bin316/beidou_4g/Docs/ChangeLogs/2026-09-20.md

# 2026-09-20

- 功能码 0 恢复 `geo_source` 字节；数据域固定为 26 字节，整帧固定为 37 字节。
- GNSS NVM 记录新增格式魔数与定位来源，旧格式启动时清空坐标并写入新记录。
- GNSS、LBS 和功能码 19 坐标写入分别持久化来源值 1、2、3；上报从同一 GNSS 快照读取坐标与来源。
- 验证：ARM GCC 已完成相关源文件语法检查；尚未进行实机重启、Flash 同步失败注入和服务端联调。
