bin316/beidou_4g/Docs/ChangeLogs/2026-09-22.md

# 2026-09-22

- 功能码 13 改为验证主备 TCP 连接后再提交系统参数；失败时恢复旧系统、传感器和 LTE 配置，并尝试重连原活动端点。
- AIR780 TCP 连接支持按调用方指定每次超时、尝试次数和退避间隔；失败尝试会清理链路状态并喂狗。
- Flash 同步返回擦除、编程与读回校验结果，功能码 13 可在提交失败时回退。
- 兼容 v2.2 功能码 26–33：雨量功能未编译时，回复对应的“功能不可用”结果码；功能码 0 上报结构未改动。
- 验证：ARM GCC 已完成 NVM、AIR780EP、Solution 语法检查；尚未进行 Air780E、服务端与 Flash 故障注入实测。
