bin316/beidou_4g/Docs/ChangeLogs/2026-09-23.md

# 2026-09-23

- 功能码 0 上报的倾角字段改为 `uint8_t`（0～180°），数据域调整为 25 字节，整帧调整为 36 字节。
- 验证：已通过协议结构体静态断言与源码检索；尚未进行服务端联调或硬件实测。
- 功能码 17 固件版本查询仅接受零长度数据域；合法请求回复功能码 16 的年、月、修订号及活动槽位。
- 单槽固件默认上报活动槽位 A（`active_slot=0`），并补充版本回复帧与运行日志说明。
- 验证：已完成协议字段检索与 `git diff --check`；当前环境无 ARM 交叉编译器，未进行编译、服务端联调或硬件实测。
