bin316/beidou_4g/Docs/IssueLogs/2026-09-23.md

# 2026-09-23

## [待验证] 倾角上报仅出现 0～90°

- 现象：上报倾角观测值仅在 0～90° 范围内，需确认是否应覆盖倒置姿态。
- 证据：`util_calculate_angle_relative_to_z()` 使用 `acosf(z / |a|)` 计算重力向量与 +Z 轴的夹角，理论结果为 0～180°；上报端仅将该值转换为 `uint8_t`，未作 90° 限幅。
- 判断：若持续小于等于 90°，测量时的 Z 轴加速度未为负。可能是设备只在正 Z 半球倾斜，或传感器安装方向/轴符号与预期不一致；尚无原始三轴实测值，不能确认具体原因。
- 方案：待实施。分别在正放、侧放、倒置静止时记录上报的 X/Y/Z 与倾角；倒置时 Z 应为负且倾角应接近 180°。若业务需要“相对初始姿态的双向倾角”，需另行定义参考面与符号编码。
- 验证：已完成源码链路检查；未进行硬件姿态测试。
