bin316/beidou_4g/solution/Solution.h

/*
 * Solution.h
 *
 *  Created on: Jan 22, 2025
 *      Author: IRIS
 */

#ifndef SOLUTION_H_
#define SOLUTION_H_

#include "Protocol.h"
#include "utilties.h"

//******FreeRTOS Family Bucket******//
#include "FreeRTOS.h"
#include "cmsis_os2.h"
#include "timers.h"
#include "queue.h"
#include "task.h"
#include "message_buffer.h"
#include "stream_buffer.h"
#include "semphr.h"

#include "os_Allocator.hpp"
#include "NVM.h"

#include "AIR780EP.h"

typedef enum : uint8_t
    {
    wm_idle,
    wm_work,
    wm_factory = 0xFF
    } solution_mode_e;

typedef struct
    {
    pb_runningConfig runningConfig;
    pb_systemConfig systemConfig;
    password pwd;
    solution_mode_e mode;
    uint8_t configEditting = 0;
    uint8_t passwordConfirm = 0;
    password newPassword =
	{
	0
	};
    util_lowpower_wake_source_e wakeSource =
	    util_lowpower_wake_source_e::regular;
    bool connect_to_main_server = false;
    bool updatePositionOnStart = false;
    /** 定位开关 bit0 GNSS / bit1 AGNSS / bit2 LBS，随 solution NVM 持久化 */
    uint8_t locate_switch = 0;

    void clear_work(void)
	{
	pwd =
	    {
	    0
	    };
	mode = solution_mode_e::wm_factory;
	configEditting = 0;
	passwordConfirm = 0;
	newPassword =
	    {
	    0
	    };
	wakeSource = util_lowpower_wake_source_e::regular;
	}
    } solution_handle;

class Solution: public osAllocator<Solution>
    {
public:
    Solution(void);

private:

    solution_handle rt_solution;

    NVM *nvm;

    AIR780EP *air;

    bool solution_boot_fine = false;

    uint32_t parse_unix_time(void);
    void unique_identifier_generate(void);

    void report(void);
    void restart(void);
    void timers_create(void);
    void refresh_server(void);
    /** 重置设备休眠倒计时；硬计时策略下收包路径不再调用 */
    void refresh_device(void);

    int send_message(void *msg, uint16_t len);
    int read_message(void *dest, uint16_t len);

    void event_process(void);
    void setup_network(void);

    void event_action_vibration(void);
    void event_action_message(void);
    /** 从业务 TCP 字节流持续提取完整协议帧，兼容黏包和拆包。 */
    void process_downlink_frame(uint8_t *message, size_t received_size);
    /** Timer 投递的服务器超时上报（工作线程执行） */
    void event_action_server_report(void);
    /** Timer 投递的在线超时休眠（工作线程执行） */
    void event_action_device_sleep(void);
    /** 按 locate_switch 启 GNSS/AGNSS（不含 LBS） */
    void start_locate(void);
    /** 震动唤醒路径调用：locateSwitch.LBS 开且北斗未定住时启 LBS 会话 */
    void start_lbs_if_needed(void);
    /** 对齐 Slope：启 LBS 会话（满 4h 后本唤醒最多 N 次，事件循环执行） */
    void lbs_session_start(void);
    /** 对齐 Slope：处理到期的 LBS 查询/重试 */
    void lbs_process_due(void);
    /** LBS 失败/暂不可用时改期重试 */
    void lbs_schedule_retry(void);

    void message_report(void);
    void message_upload_run_parameters(void);
    void message_change_run_parameters(pb_runningConfig *params);
    void message_sleep(void);
    /** 功能码 9：进/退配置模式、改密；req 为 null 或 dataLen 非法时回失败 */
    void message_enter_config_mode(pb_configModeReq *req);
    void message_upload_sys_parameters(void);
    void message_change_sys_parameters(pb_systemConfig *params);
    void message_change_execute_mode(solution_mode_e *mode);
    /** 下行 17 的零长度查询：上行 16 回 year/month/revision/active_slot。 */
    void message_upload_firmware_version(void);
    /** 下行19：写经纬度到 GNSS 缓存并落 NVM */
    void message_config_locate_geo(pb_locateGeo *geo);
    /** 下行21：改 locateSwitch；应答20：1成功/0一般失败/2非法AGNSS */
    void message_config_locate_switch(uint8_t *value);
    /** 下行23：查询 locateSwitch */
    void message_upload_locate_switch(void);
    /**
     * 下行25：OTA 请求；本机无升级能力时桩应答上行24
     * dataLen 非法→result=5；否则→result=0（拒绝）
     */
    void message_ota_request(const pb_otaRequest *req);
    /** 雨量功能未编译时，用 v2.2 对应结果码明确返回“不支持”。 */
    void message_rain_feature_unsupported(e_pb_func response_func,
	uint8_t unavailable_result);
    /** 功能码 35：仅当前唤醒抑制自动休眠；0/1 成功回显，非法值以功能码 34 回 0xFF。 */
    void message_keep_online_this_wake(uint8_t value);
    /** 服务器 OK：仅 awaiting_report_ok_ 时可能休眠（对齐 Inclination） */
    void message_heartbeat(void);
    void mark_report_pending_ack(void);
    void clear_report_pending_ack(void);

    /** true=最近一次成功发出 up_report，下一条 OK 视为上报确认 */
    bool awaiting_report_ok_ = false;
    /** 仅 RAM 有效；本次唤醒期间拦截 OK/超时触发的自动休眠。 */
    bool keep_online_this_wake_ = false;

    /** Timer 回调只置位；工作线程轮询并执行可能阻塞的上报/休眠。 */
    volatile bool server_report_due_ = false;
    volatile bool device_sleep_due_ = false;

    static constexpr size_t kDownlinkFrameCapacity = 320u;
    uint8_t downlink_frame_[kDownlinkFrameCapacity] = {};
    size_t downlink_frame_len_ = 0u;

    /** 当前配置会话意图（RAM）；进 Standby/退出时清零，不落 NVM */
    uint8_t config_intent_ = 0;
    /** 是否允许执行指定写功能码（配置态且 intent 匹配） */
    bool config_write_allowed(uint8_t write_func) const;
    /** 进 Standby 前清除配置会话，避免跨睡残留 editing 而无 intent */
    void clear_config_session_for_standby(void);

    /** 功能码 13 验证新端点期间阻止定时器投递 report/休眠事件。 */
    bool endpoint_switch_in_progress_ = false;
    bool endpoint_switch_endpoint_valid(const uint8_t ip[4],
	uint16_t port) const;
    bool endpoint_switch_connect(AIR780EP::air780_server_t server,
	uint8_t attempts);
    void endpoint_switch_pause_timers(bool *server_was_active,
	bool *device_was_active);
    void endpoint_switch_resume_timers(bool server_was_active,
	bool device_was_active);

//	服务器响应超时定时器相关变量
    TimerHandle_t server_timeout_timer;
    const char *server_timeout_timer_name = "server_timeout_timer";
    static void server_timeout_timer_callback(TimerHandle_t xTimer);
//	设备超时休眠定时器相关变量
    TimerHandle_t device_timeout_timer;
    const char *device_timeout_timer_name = "device_timeout_timer";
    static void device_timeout_timer_callback(TimerHandle_t xTimer);
    /** LBS 失败/暂不可用时的改期定时器（对齐 Slope） */
    TimerHandle_t lbs_retry_timer = nullptr;
    static void lbs_retry_timer_callback(TimerHandle_t xTimer);

    TaskHandle_t solution_thread_handle = NULL;
    static void solution_work_routine_thread(void *argument);
    static void solution_idle_routine_thread(void *argument);
    static void solution_fact_routine_thread(void *argument);
    };

#endif /* SOLUTION_H_ */
