bin316/beidou_4g/bsp/util_low_power.cpp

/*
 * util_low_power.cpp
 *
 *  Created on: Oct 21, 2024
 *      Author: IRIS
 */

#include "PRODUCT_CONFIG.h"

#include "main.h"
#include "i2c.h"
#include "rtc.h"
#ifdef DEBUG
#include "usart.h"
#endif
#if PROD_CONFIG_FACTORY_ENABLE_IWDG
#include "iwdg.h"
#endif

#include "stdint-gcc.h"
#include "stdio.h"
#include "stdlib.h"
#include "string.h"
#include "typeinfo"
#include "time.h"

#include "FreeRTOS.h"
#include "task.h"
#include "queue.h"
#include "stream_buffer.h"
#include "message_buffer.h"
#include "semphr.h"
#include "timers.h"

#include "utilties.h"

#include "magic_enum.hpp"
using namespace magic_enum;

static util_lowpower_wake_source_e wake_source =
		util_lowpower_wake_source_e::pin;

static util_lowpower_config_s factory_lowpower_config = { .wake_pin_enable =
		false, .requested_wakeup_period = 0, .wakeup_remain = 0, };

static util_lowpower_config_s rt_lowpower_config;

#include "NVM.h"

NVM *nvm_lopwr = NULL;

#if PROD_CONFIG_FACTORY_ENABLE_IWDG
static TimerHandle_t iwdg_feed_timer = NULL;
#endif
//this delay must be greater than 0.1s
#define LOWPOWER_STANDBY_DELAY	250

#if PROD_CONFIG_FACTORY_ENABLE_IWDG
static void util_lowpower_iwdg_refresh_timer_callback(TimerHandle_t xtimer) {
	util_lowpower_iwdg_feed();
	HAL_GPIO_TogglePin(LED_BOOT_GPIO_Port, LED_BOOT_Pin);
}
#endif
/*
 * 低功耗初始化流程：
 *	1. 读取配置，检查是否需要休眠
 *		1)如果处在休眠状态（剩余时长不为0），根据剩余的休眠时长继续休眠
 *		2)如果剩余时长为0，退出休眠状态，初始化完成，系统继续运行
 * */
extern int INT1_PIN_STATE;
void __util_lowpower_init__(void) {
	// 检查是否是由RTC唤醒
	nvm_lopwr = new NVM(NVM::partition_lowpower, &rt_lowpower_config,
			&factory_lowpower_config, sizeof(rt_lowpower_config));
	configASSERT(nvm_lopwr != NULL);
	nvm_lopwr->load();
	if (nvm_lopwr->isFactoryDefault()) {
		nvm_lopwr->restoreDefault();
		nvm_lopwr->save();
		logInfo("NVM: 已恢复出厂默认");
	}

	/*timezone setup：POSIX 符号与日常相反，UTC-8 = 东八区北京时间（对齐 Inclination） */
	setenv("TZ", "UTC-8", 1);
	tzset();             // 更新时区设置

	/* 上电打印复位原因，便于区分 IWDG / SoftReset(HardFault后) / 引脚复位 */
	{
		const uint32_t csr = RCC->CSR;
		if (csr & RCC_CSR_IWDGRSTF) {
			logWarning("复位原因: 独立看门狗(IWDG)");
		}
		if (csr & RCC_CSR_SFTRSTF) {
			logWarning("复位原因: 软件复位(常见于HardFault闪灯后SystemReset)");
		}
		if (csr & RCC_CSR_PINRSTF) {
			logInfo("复位原因: NRST引脚(常与其它标志同时置位)");
		}
		if (csr & RCC_CSR_BORRSTF) {
			logWarning("复位原因: 欠压BOR");
		}
		__HAL_RCC_CLEAR_RESET_FLAGS();
	}

	/*
	 * 创建看门狗刷新定时器
	 * 创建后立即刷新一次看门狗，然后再启动定时器
	 * */
#if PROD_CONFIG_FACTORY_ENABLE_IWDG
	util_lowpower_iwdg_feed();
	iwdg_feed_timer = xTimerCreate("iwdg_refresh", pdMS_TO_TICKS(200), pdTRUE,
	NULL, util_lowpower_iwdg_refresh_timer_callback);
	configASSERT(iwdg_feed_timer!=NULL);
	xTimerStart(iwdg_feed_timer, portMAX_DELAY);
	logInfo("看门狗: 喂狗定时器已创建");
#endif
// 检查是否是由Wake Up引脚唤醒
	if (__HAL_PWR_GET_FLAG(PWR_FLAG_WU) || INT1_PIN_STATE
			|| __HAL_PWR_GET_FLAG(PWR_FLAG_WUF1)
			|| (HAL_GPIO_ReadPin(SENSOR_INT1_GPIO_Port, SENSOR_INT1_Pin)
					== GPIO_PIN_SET)) {
		// 清除Wake Up引脚唤醒标志
		wake_source = util_lowpower_wake_source_e::pin;
	} else if (__HAL_RTC_WAKEUPTIMER_GET_FLAG(&hrtc, RTC_FLAG_WUTF)) {
		// 清除RTC唤醒标志
		__HAL_RTC_WAKEUPTIMER_CLEAR_FLAG(&hrtc, RTC_FLAG_WUTF);
		wake_source = util_lowpower_wake_source_e::rtc;
	} else {
		wake_source = util_lowpower_wake_source_e::regular;
	}
	logInfo("唤醒源: %s", enum_name(wake_source).data());

	if (rt_lowpower_config.wakeup_remain == 0) {
		logInfo("低功耗: 休眠结束(剩余0)");
		return;
	}
	if (rt_lowpower_config.wake_pin_enable
			&& wake_source == util_lowpower_wake_source_e::pin) {
		rt_lowpower_config.wakeup_remain = 0;
		nvm_lopwr->save();
		logInfo("低功耗: 引脚打断休眠");
		return;
	}

	/*持续休眠流程*/
	uint32_t seconds = 0;
	if (rt_lowpower_config.wakeup_remain > 64800) {
		/*如果剩余休眠时间大于18h...*/
		seconds = 64800;
		rt_lowpower_config.wakeup_remain -= 64800;
	} else {
		/*如果剩余休眠时间小于18h...*/            
		seconds = rt_lowpower_config.wakeup_remain;
		rt_lowpower_config.wakeup_remain = 0;
	}

	logInfo("低功耗: 继续休眠, 剩余%d秒",
			rt_lowpower_config.wakeup_remain);

	nvm_lopwr->save();
	/*$notice 继续休眠时，写入一次flash*/
	__flash_sync();
	// 设置RTC唤醒定时器
	HAL_RTCEx_SetWakeUpTimer_IT(&hrtc,
			(seconds > 2) ? (seconds - 1) : (seconds),
			RTC_WAKEUPCLOCK_CK_SPRE_16BITS);
	// 清除RTC和Wake Up标志
	__HAL_RTC_WAKEUPTIMER_CLEAR_FLAG(&hrtc, RTC_FLAG_WUTWF);
	__HAL_RTC_WAKEUPTIMER_CLEAR_FLAG(&hrtc, RTC_FLAG_WUTF);
	__HAL_PWR_CLEAR_FLAG(PWR_FLAG_WU);
	__HAL_PWR_CLEAR_FLAG(PWR_FLAG_WUF1);
	HAL_PWREx_EnableInternalWakeUpLine();

	// 进入待机模式
//	HAL_PWREx_EnterSHUTDOWNMode();
	HAL_PWREx_EnablePullUpPullDownConfig(); // 允许 Standby 模式下的上下拉配置
	HAL_PWREx_EnableGPIOPullDown(PWR_GPIO_A, PWR_GPIO_BIT_0);
	HAL_PWREx_EnableGPIOPullDown(PWR_GPIO_A, PWR_GPIO_BIT_1);
	HAL_PWR_EnterSTANDBYMode();
}

/*
 * 休眠流程：
 * 	1.读取（同步）低功耗配置
 * 	2.等待一段时间，确保所有设备完成操作
 * 	3.根据设定的总休眠时间计算本次休眠时间
 * 	4.根据唤醒源设置唤醒中断
 *
 * */
void util_lowpower_standby(void) {
	unsigned int seconds;
	bool wake_pin_enable = rt_lowpower_config.wake_pin_enable;
	logInfo("低功耗: 唤醒引脚%s", wake_pin_enable ? "开" : "关");
	/*
	 * 根据requested_wakeup_period开启一次新的休眠
	 * */
	if (rt_lowpower_config.requested_wakeup_period < 3) {
		rt_lowpower_config.wakeup_remain = 0;
		rt_lowpower_config.requested_wakeup_period = 0;
		/*最低休眠3s*/
		seconds = 3;
	}
	if (rt_lowpower_config.requested_wakeup_period > 64800) {
		seconds = 64800;
		rt_lowpower_config.wakeup_remain =
				rt_lowpower_config.requested_wakeup_period - 64800;
	} else {
		seconds = rt_lowpower_config.requested_wakeup_period;
		rt_lowpower_config.wakeup_remain = 0;
	}

	logInfo("低功耗: 请求休眠%d秒",
			rt_lowpower_config.requested_wakeup_period);
	logInfo("低功耗: 剩余分段%d秒", rt_lowpower_config.wakeup_remain);
	logInfo("低功耗: 本段休眠%d秒", seconds);

	nvm_lopwr->save();

	__flash_sync();
	//	等待其余设备执行完成

	/* 任何等待都必须在 critical 前完成，critical 内只保留待机寄存器配置。 */
	vTaskDelay(pdMS_TO_TICKS(LOWPOWER_STANDBY_DELAY));

	taskENTER_CRITICAL();
//	进入关键区后，所有依赖freertos的组件都将失效（包括调试串口）
// 使能唤醒中断
	if (wake_pin_enable) {
		HAL_PWR_EnableWakeUpPin(PWR_WAKEUP_PIN1);
	} else {
		HAL_PWR_DisableWakeUpPin(PWR_WAKEUP_PIN1);
	}

	// debug: 强制禁用唤醒引脚
	// HAL_PWR_DisableWakeUpPin(PWR_WAKEUP_PIN1);

// 设置RTC唤醒定时器
	HAL_RTCEx_SetWakeUpTimer_IT(&hrtc,
			(seconds > 2) ? (seconds - 1) : (seconds),
			RTC_WAKEUPCLOCK_CK_SPRE_16BITS);
	HAL_PWREx_EnableInternalWakeUpLine();
// 清除RTC和Wake Up标志

	/*$notice 请求休眠时，写入一次flash*/
// 进入待机模式
	__HAL_RTC_WAKEUPTIMER_CLEAR_FLAG(&hrtc, RTC_FLAG_WUTWF);
	__HAL_RTC_WAKEUPTIMER_CLEAR_FLAG(&hrtc, RTC_FLAG_WUTF);

	__HAL_PWR_CLEAR_FLAG(PWR_FLAG_WUF1);
	__HAL_PWR_CLEAR_FLAG(PWR_FLAG_WUF2);
	__HAL_PWR_CLEAR_FLAG(PWR_FLAG_WUF3);
	__HAL_PWR_CLEAR_FLAG(PWR_FLAG_WUF4);
	__HAL_PWR_CLEAR_FLAG(PWR_FLAG_WUF5);
	__HAL_PWR_CLEAR_FLAG(PWR_FLAG_WU);
	__HAL_PWR_CLEAR_FLAG(PWR_FLAG_SB);

#ifdef DEBUG
	// 串口日志已经失效，使用普通的串口打印输出
	uartPrintStr(&huart2, "\r\n进入休眠状态\r\n");
#endif

	HAL_PWREx_EnablePullUpPullDownConfig(); // 允许 Standby 模式下的上下拉配置
	HAL_PWREx_EnableGPIOPullDown(PWR_GPIO_A, PWR_GPIO_BIT_0);
	HAL_PWREx_EnableGPIOPullDown(PWR_GPIO_A, PWR_GPIO_BIT_1);
	HAL_PWR_EnterSTANDBYMode();

	/*should never reach here*/
	taskEXIT_CRITICAL();
}

util_lowpower_wake_source_e util_lowpower_get_wake_source(void) {
	return wake_source;
}

util_lowpower_config_s util_lowpower_get_config(void) {
	return rt_lowpower_config;
}
void util_lowpower_set_config(util_lowpower_config_s config) {
	rt_lowpower_config.requested_wakeup_period = config.requested_wakeup_period;
	rt_lowpower_config.wake_pin_enable = config.wake_pin_enable;
	rt_lowpower_config.wakeup_remain = config.wakeup_remain;
	nvm_lopwr->save();
}

void util_lowpower_iwdg_feed(void) {
#if PROD_CONFIG_FACTORY_ENABLE_IWDG
	HAL_IWDG_Refresh(&hiwdg);
#endif
}

/*
 * @brief 用 unix 时间写 RTC（按当前 TZ，工程为东八区）
 * @return 0 成功；-1 时间非法（不改 RTC）
 */
int util_lowpower_update_rtc(time_t time) {
	/* mktime 失败为 -1；拒绝写入以免 Year 下溢成 2226 等脏值 */
	if (time == (time_t) -1 || time < 0) {
		logWarning("RTC: 拒绝非法时间戳 %ld", (long) time);
		return -1;
	}

	struct tm *plocal = localtime(&time);
	if (plocal == nullptr) {
		logWarning("RTC: localtime 失败 时间戳 %ld", (long) time);
		return -1;
	}
	struct tm local = *plocal;

	/* STM32 RTC 年字段仅 0..99（2000..2099） */
	if (local.tm_year < 100 || local.tm_year > 199) {
		logWarning("RTC: 年份越界 tm_year=%d", local.tm_year);
		return -1;
	}

	RTC_TimeTypeDef sTime;
	RTC_DateTypeDef sDate;

	sTime.Hours = (uint8_t) local.tm_hour;
	sTime.Minutes = (uint8_t) local.tm_min;
	sTime.Seconds = (uint8_t) local.tm_sec;

	sDate.WeekDay = (uint8_t) local.tm_wday;
	sDate.Month = (uint8_t) (local.tm_mon + 1);
	sDate.Date = (uint8_t) local.tm_mday;
	sDate.Year = (uint8_t) (local.tm_year - 100);

	logInfo("RTC: 已设置 %02d:%02d:%02d %02d/%02d/%02d", sTime.Hours,
			sTime.Minutes, sTime.Seconds, sDate.Year + 2000, sDate.Month,
			sDate.Date);
	logInfo("RTC: 时间戳 %ld", (long) time);
	HAL_RTC_SetDate(&hrtc, &sDate, RTC_FORMAT_BIN);
	HAL_RTC_SetTime(&hrtc, &sTime, RTC_FORMAT_BIN);
	return 0;
}

time_t util_lowpower_get_rtc(void) {
	time_t time;
	struct tm local;

	RTC_TimeTypeDef sTime;
	RTC_DateTypeDef sDate;

	HAL_RTC_GetTime(&hrtc, &sTime, RTC_FORMAT_BIN);
	HAL_RTC_GetDate(&hrtc, &sDate, RTC_FORMAT_BIN);

	local.tm_hour = sTime.Hours;
	local.tm_min = sTime.Minutes;
	local.tm_sec = sTime.Seconds;
	local.tm_wday = sDate.WeekDay;
	local.tm_mon = sDate.Month - 1;
	local.tm_mday = sDate.Date;
	local.tm_year = sDate.Year + 100;

	time = mktime(&local);

	return time;
}
