bin316/beidou_4g/bsp/util_system_events.cpp

/*
 * events.cpp
 *
 *  Created on: Oct 21, 2024
 *      Author: IRIS
 */

#include <utilties.h>
#include "main.h"

#include "stdint-gcc.h"
#include "stdio.h"
#include "stdlib.h"
#include "string.h"

#include "FreeRTOS.h"
#include "task.h"
#include "queue.h"
#include "stream_buffer.h"
#include "message_buffer.h"
#include "semphr.h"
#include "event_groups.h"

#include "utilties.h"
#include "log.h"

static QueueHandle_t event_queue;

#define IDLE_EVENT_DELAY 100

void __util_events_init__(void) {
	event_queue = xQueueCreate(16, sizeof(util_event_code_t));
	configASSERT(event_queue);
	logInfo("事件队列: 已初始化");
}

void util_events_generate(util_event_code_t code) {
	if (xPortIsInsideInterrupt()) {
		xQueueSendFromISR(event_queue, &code, NULL);
	} else {
		xQueueSend(event_queue, &code, portMAX_DELAY);
	}
}

void util_events_generate_noblock(util_event_code_t code) {
	if (event_queue == NULL) {
		return;
	}
	if (xPortIsInsideInterrupt()) {
		BaseType_t hpw = pdFALSE;
		(void) xQueueSendFromISR(event_queue, &code, &hpw);
		portYIELD_FROM_ISR(hpw);
	} else {
		(void) xQueueSend(event_queue, &code, 0);
	}
}

bool util_events_poll(util_event_code_t *code, size_t timeout) {
	return xQueueReceive(event_queue, code, pdMS_TO_TICKS(timeout));
}

bool util_events_poll_nonblocked(util_event_code_t *code) {
	return xQueueReceive(event_queue, code, 0);
}

int util_events_flush(void) {
	int dropped = 0;
	util_event_code_t code;
	while (xQueueReceive(event_queue, &code, 0) == pdPASS) {
		dropped++;
	}
	if (dropped > 0) {
		logInfo("事件队列: 清空%d条", dropped);
	}
	return 0;
}
