bin316/beidou_4g/(commit log)

2025-05-03 test：死机问题仍然没有解决
2025-05-03 fix：将存储xuart实例到hal库串口句柄映射的map机制修改为静态数组
2025-05-28 fix：修复了联网等待逻辑、定时器堆栈容量翻倍
    上一版本假定air780一定会联网成功，因此每次开机后会无限循环“发送连接指令--testif连接成功”，因此如果偶尔网络连接失败，界桩会在网络链接阶段卡住。这个版本修改了这个问题，限制最大连接次数为3.
    软件定时器堆栈在上一版本中似乎太小，有时在服务器响应超时定时器回调中调用report时，此时会调用标准库sprintf，堆栈溢出。这个问题在cubeide的FreeRTOS堆栈检查工具中发现。当前版本翻倍了定时器任务堆栈大小，经测试，未发现堆栈溢出导致复位。
2025-06-04 fix:修复了休眠接力功能中的bug
    当引脚唤醒被使能，并且本次唤醒由引脚触发时，本次休眠接力结束。上一版本中，判断逻辑为“引脚唤醒使能&&非引脚唤醒”，此逻辑有误，已经修复
2025-06-04 fix:恢复了若干测试过程中没有恢复的代码
    测试过程中将北斗模块取下并将其串口功能改为shell，并修改了波特率，多处代码在最终测试中未恢复：未恢复与北斗模块匹配的波特率，未取消shell进程的初始化，未打开北斗串口和北斗解析进程。导致服务器无法正常刷新定位。上述问题已在本版本修复。
2025-06-06 fix：修复了硬件导致的电池电压测量示数偏低的问题
    由于硬件上将测量电池电压的引脚连接到了二极管后面，导致测量电池电压偏低，本次修改为电池电压增加了固定常数0.3，使得电压测量在大部分情况下在十分位上都能和实际电压对应；此外还修改了一些运行参数，如休眠周期更改为48小时等。
2026-01-15 交接，导入EIDE
2026-01-23 feat(sys): 优化低功耗调试逻辑并修复传感器采样错误
    - feat(uart): 新增 uartPrintStr 函数，用于在进入低功耗模式关闭日志模块后，直接通过串口打印调试信息。
    - fix(sensor): 将 sc7a20 采样计算从 pitch 修改为 lean_angle，修复了校准值获取不准的问题。
    - conf(app): 修改默认配置，将工作模式设为工厂模式，并将默认连接服务器切换为主服务器。
    - chore(log): 增加部分DEBUG调试日志。
    [PRODUCT_CONFIG.h, Solution.cpp, util_low_power.cpp, util_sc7a20.cpp]
2026-01-27 refactor(xuart): 增加串口工作模式支持 fix(shell): 修复启用shell时，终端串口与北斗串口冲突的问题
    [Xuart.cpp, Xuart.h, util_shell.cpp]
2026-01-29 fix: 更新默认状态和日志信息，调整测试代号索引
2026-02-26 test: 待机下开启引脚上拉与下拉
2026-07-22 feat: AGNSS/LBS定位链路、RTT调试与定位开关协议
    对齐合宙LBS限频会话与中科微AGNSS注入；修复上报栈溢出路径；完善locateSwitch(GNSS/AGNSS/LBS)校验与应答码。
    [daplink-openocd.cfg]
2026-07-27 稳时区与定位链路，修 HardFault，配置会话带意图
    feat(locate): 以 locate_switch bit0/1/2 替代 GNSS_HW/AGNSS_ENABLE/LBS_FALLBACK 编译闸门
    add(config): PROD_CFG_DEFAULT_LOCATE_GNSS/AGNSS/LBS 仅定出厂默认，运行只看 NVM
    feat(proto): 功能码 18/19 写经纬度、20/21/22/23 改查定位开关；开 AGNSS 须同时开 GNSS 否则应答 2
    feat(lbs): 相对 NVM 历史 ≤PROD_CFG_LBS_NVM_KEEP_MAX_M(1km) 保留旧点且不抬 geoStat
    fix(lbs): 去掉 LBS 滚动平均；geo_src 支持 SERVER；采纳 LBS 才 geoStat=1
    feat(proto): 配置模式 password+intent(dataLen9)，应答 result+intent(dataLen2)，失败 intent 恒 0
    feat(config): 进模式意图 5/13/15/19/21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
    [AIR780EP.cpp, BufferedUart.cpp, NVM.cpp, PRODUCT_CONFIG.h, Protocol.h, Solution.cpp, Solution.h]
2026-09-23 协议补齐与运行链路加固，分区堆缓解内存压力
    feat(heap): FreeRTOS 由 heap_4 切换至 heap_5，将 4KB 堆放入 SRAM2，并在创建 RTOS 对象前登记 RAM1/RAM2 堆区
    fix(nvm): flash_sync/NVM::sync 返回 bool，增加擦除、写入及页回读校验；配置写入仅在持久化成功后回成功
    fix(net): 系统配置切换服务器前校验端点，暂停超时定时器并验证主备链路；失败时回滚内存、Flash 与连接状态
    fix(analog): 低电阈值统一为 0.1V，迁移旧伏特单位 NVM 配置；低电判定与上报电压使用相同四舍五入规则
    feat(gnss): 坐标增加 GNSS/LBS/服务器来源并写入 NVM；通过格式标记清理旧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
    [AIR780EP.cpp, AIR780EP.h, NVM.cpp, NVM.h, PRODUCT_CONFIG.h, Protocol.h, Solution.cpp, Solution.h]
2026-09-30 加固 TCP 下行组帧与本次唤醒保持在线控制
    feat(proto): 新增功能码 34/35，支持仅当前唤醒周期保持在线及非法参数兼容应答
    fix(proto): 以连续字节流组装下行帧，补充帧边界、CRC 范围和固定载荷长度校验
    refactor(net): AIR780EP 业务下行改用 StreamBuffer，兼容 TCP 黏包、拆包和跨 UART 批次的 +RECEIVE
    fix(net): 建连失败后等待链路关闭确认，避免迟到 CONNECT OK 污染后续重试
    fix(net): 保留断链前已接收的业务字节，避免 RX 与业务线程并发释放缓冲区
    fix(power): 定时器回调仅置位，由工作线程执行上报和休眠；待机延时移出临界区
    feat(power): RTC 例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
    [AIR780EP.cpp, AIR780EP.h, Protocol.h, Solution.cpp, Solution.h, util_low_power.cpp]
