bin316/beidou_4g/(notices)

Notices in the files:
Core/Inc/main.h:
Copyright (c) 2025 STMicroelectronics.
All rights reserved.
This software is licensed under terms that can be found in the LICENSE file
shell/shell_readme.md:
License: MIT
